svcguy/orpMeter/README.md

# orpMeter
## A basic combination pH/ORP(redox) probe electrometer circuit
This is a simple analog front end (AFE), ADC, isolated DC-DC, and SPI isolator circuit to interface to a standard combination pH or ORP probe.

## Circuit Theory of Operation
### AFE
(coming soon)
