svcguy/orpMeter/(list of files, cad)

Other CAD files:
fab/orpMeter-B_SilkS.dxf
fab/orpMeter-F_SilkS.dxf
