svcguy/orpMeter/orpMeter.kicad_pcb

## KiCad design orpMeter.kicad_pcb (2021-10-19)

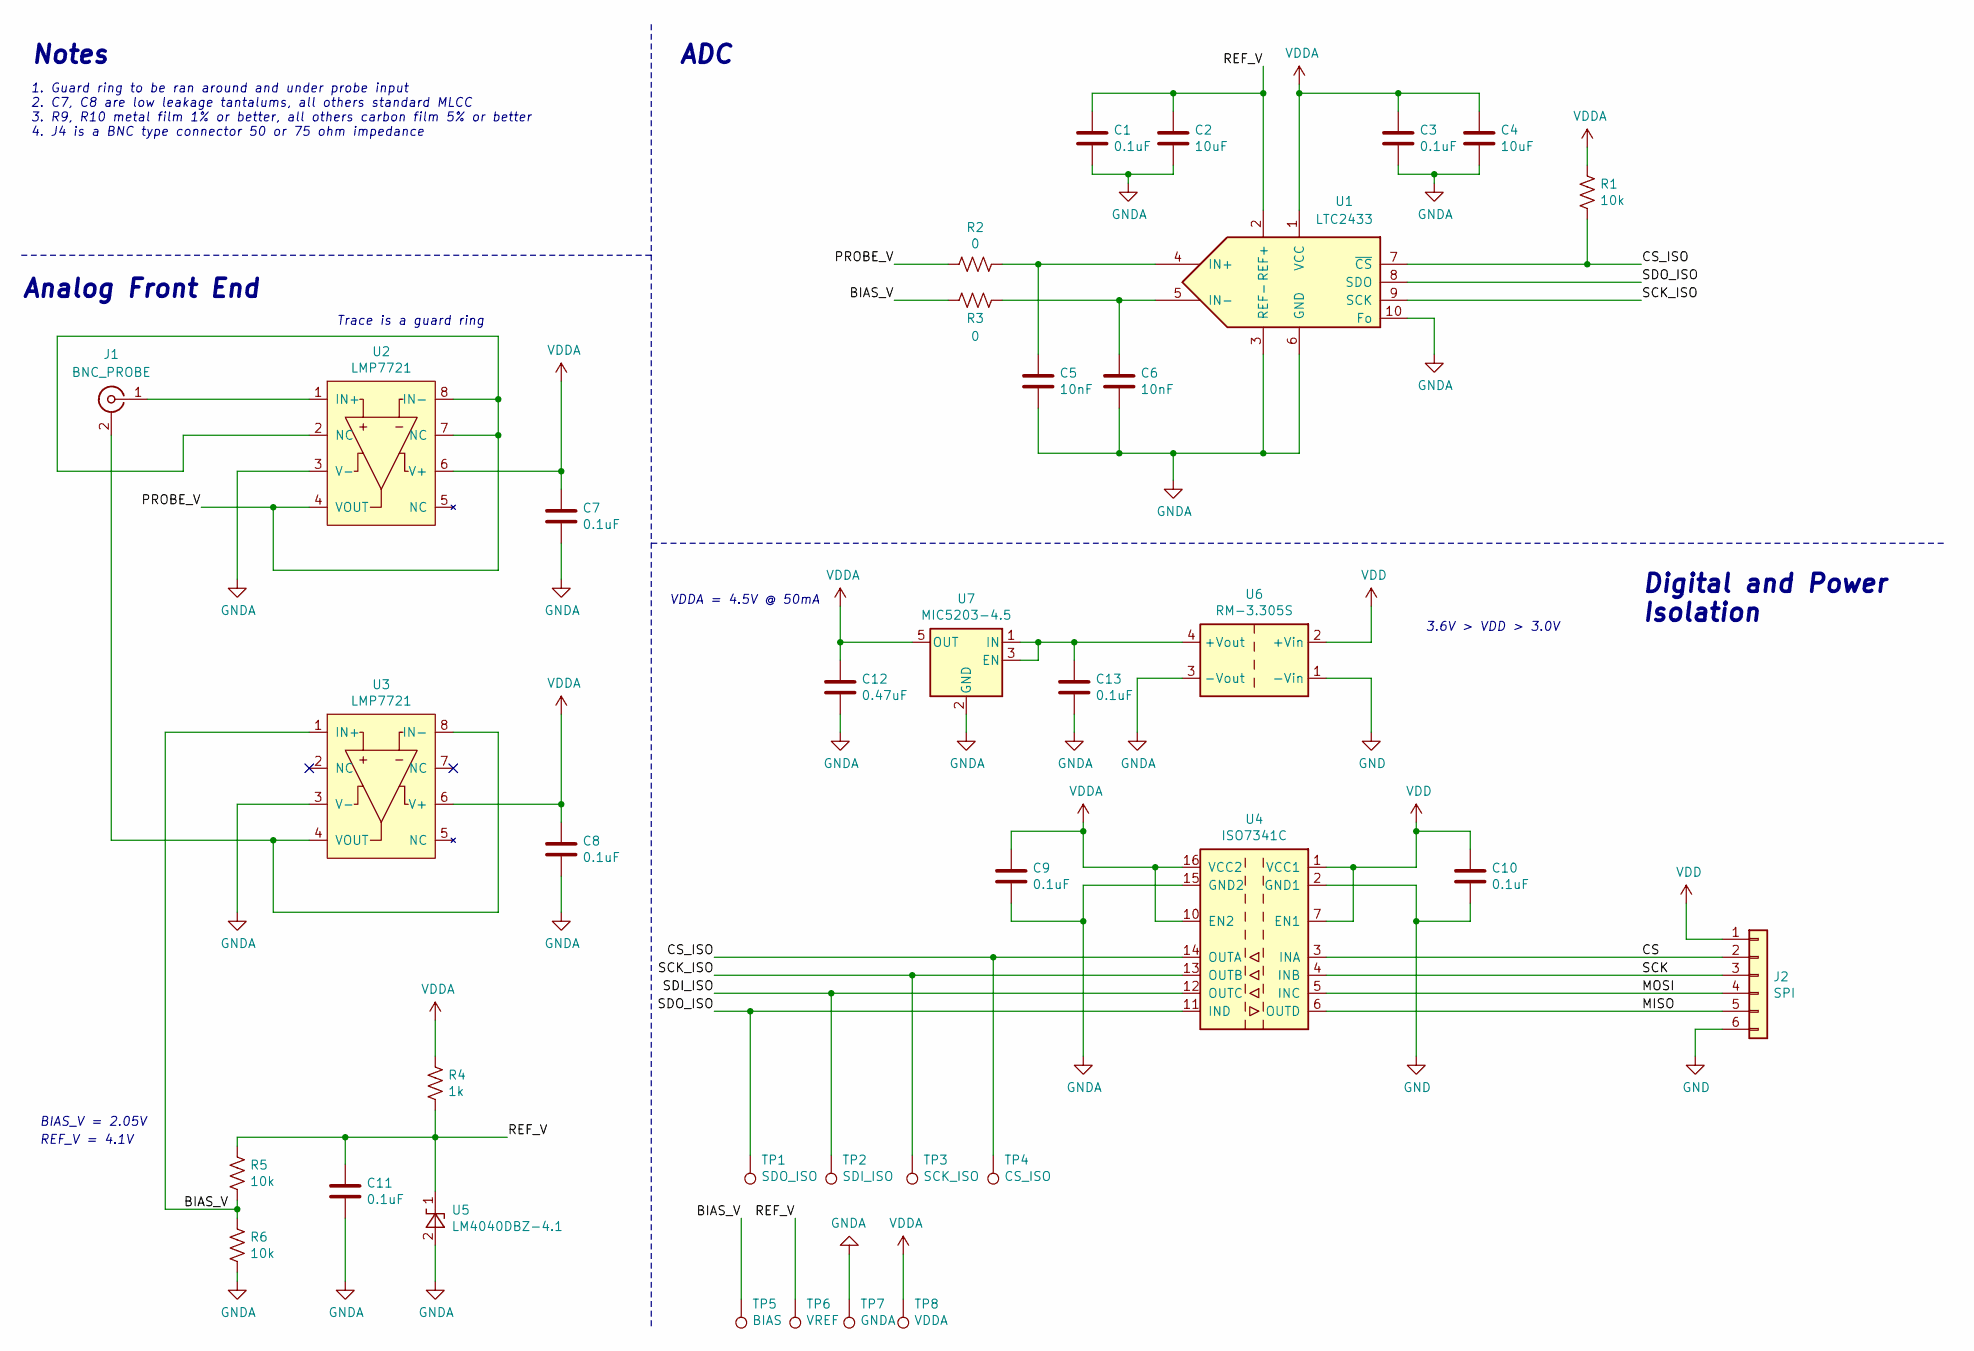
[picture p1: schematic orpMeter.sch, pH and ORP electrometer]

Parts:
C1, C3, C9, C10, C13: 0.1uF; C_0603_1608Metric; Digikey 478-3540-1-ND
C2, C4: 10uF; CP_EIA-2012-15_AVX-P
C5, C6: 10nF; C_0603_1608Metric; Digikey 399-17880-1-ND
C7, C8, C11: 0.1uF; CP_EIA-2012-15_AVX-P; Digikey 478-11592-1-ND
C12: 0.47uF; C_0603_1608Metric; Digikey 399-4922-1-ND
J1: BNC_PROBE; BNC_Amphenol_B6252HB-NPP3G-50_Horizontal; Digikey A24485-ND
J2: SPI; PinHeader_1x06_P2.54mm_Vertical; Digikey DNP
R1, R5, R6: 10k; R_0603_1608Metric; Digikey 2019-RN73H1JTTD1002B50CT-ND
R2, R3: 0; R_0603_1608Metric; Digikey 541-4013-1-ND
R4: 1k; C_0603_1608Metric; Digikey RMCF0603FG1K00CT-ND
TP1: SDO_ISO; TestPoint_Pad_2.0x2.0mm; Digikey DNP
TP2: SDI_ISO; TestPoint_Pad_2.0x2.0mm; Digikey DNP
TP3: SCK_ISO; TestPoint_Pad_2.0x2.0mm; Digikey DNP
TP4: CS_ISO; TestPoint_Pad_2.0x2.0mm; Digikey DNP
TP5: BIAS; TestPoint_Pad_2.0x2.0mm; Digikey DNP
TP6: VREF; TestPoint_Pad_2.0x2.0mm; Digikey DNP
TP7: GNDA; TestPoint_Pad_2.0x2.0mm; Digikey DNP
TP8: VDDA; TestPoint_Pad_2.0x2.0mm; Digikey DNP
U1: LTC2433; MSOP-10_3x3mm_P0.5mm; Digikey LTC2433-1CMS#PBF-ND
U2, U3: LMP7721; SOIC-8_3.9x4.9mm_P1.27mm; Digikey LMP7721IMA/NOPB-ND
U4: ISO7341C; SOIC-16W_7.5x10.3mm_P1.27mm; Digikey 296-47779-1-ND
U5: LM4040DBZ-4.1; SOT-23; Digikey LM4040DIM3-4.1/NOPBCT-ND
U6: RM-3.305S; Converter_DCDC_Murata_MEE1SxxxxSC_THT; Digikey 945-1518-5-ND
U7: MIC5203-4.5; SOT-23-5; Digikey MIC5203-4.5YM5-CT-ND

Connections:
/BIAS_V: R3.2, R5.2, R6.1, TP5.1, U3.1 (IN+)
/CS: J2.2, U4.3 (INA)
/CS_ISO: R1.2, TP4.1, U1.7 (~CS), U4.14 (OUTA)
/MISO: J2.5, U4.6 (OUTD)
/MOSI: J2.4, U4.5 (INC)
/PROBE_V: R2.2, U2.2 (NC), U2.4 (VOUT), U2.7 (NC), U2.8 (IN-)
/REF_V: C1.1, C2.1, C11.1, R4.2, R5.1, TP6.1, U1.2 (REF+), U5.1 (K)
/SCK: J2.3, U4.4 (INB)
/SCK_ISO: TP3.1, U1.9 (SCK), U4.13 (OUTB)
/SDI_ISO: TP2.1, U4.12 (OUTC)
/SDO_ISO: TP1.1, U1.8 (SDO), U4.11 (IND)
GND: C10.2, J2.6, U4.2 (GND1), U4.8 (GND1), U6.1 (-Vin)
GNDA: C1.2, C2.2, C3.2, C4.2, C5.2, C6.2, C7.2, C8.2, C9.2, C11.2, C12.2, C13.2, R6.2, TP7.1, U1.3 (REF-), U1.6 (GND), U1.10 (Fo), U2.3 (V-), U3.3 (V-), U4.9 (GND2), U4.15 (GND2), U5.2 (A), U6.3 (-Vout), U7.2 (GND)
unnamed: C5.1, R2.1, U1.4 (IN+)
unnamed: C6.1, R3.1, U1.5 (IN-)
unnamed: C13.1, U6.4 (+Vout), U7.1 (IN), U7.3 (EN)
unnamed: J1.1 (In), U2.1 (IN+)
unnamed: J1.2 (Ext), U3.4 (VOUT), U3.8 (IN-)
VDD: C10.1, J2.1, U4.1 (VCC1), U4.7 (EN1), U6.2 (+Vin)
VDDA: C3.1, C4.1, C7.1, C8.1, C9.1, C12.1, R1.1, R4.1, TP8.1, U1.1 (VCC), U2.6 (V+), U3.6 (V+), U4.10 (EN2), U4.16 (VCC2), U7.5 (OUT)

Notes on the sheet:
BIAS_V = 2.05V
Trace is a guard ring
REF_V = 4.1V
3.6V > VDD > 3.0V
VDDA = 4.5V @ 50mA
Analog Front End
ADC
Digital and Power Isolation
Notes
1. Guard ring to be ran around and under probe input 2. C7, C8 are low leakage tantalums, all others standard MLCC 3. R9, R10 metal film 1% or better, all others carbon film 5% or better 4. J4 is a BNC type connector 50 or 75 ohm impedance

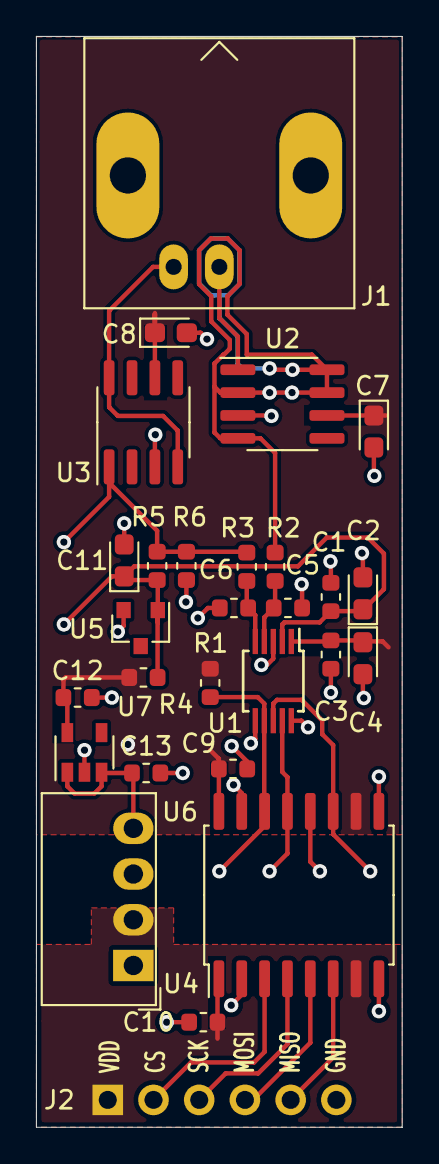
[picture p2: board orpMeter.kicad_pcb from above]

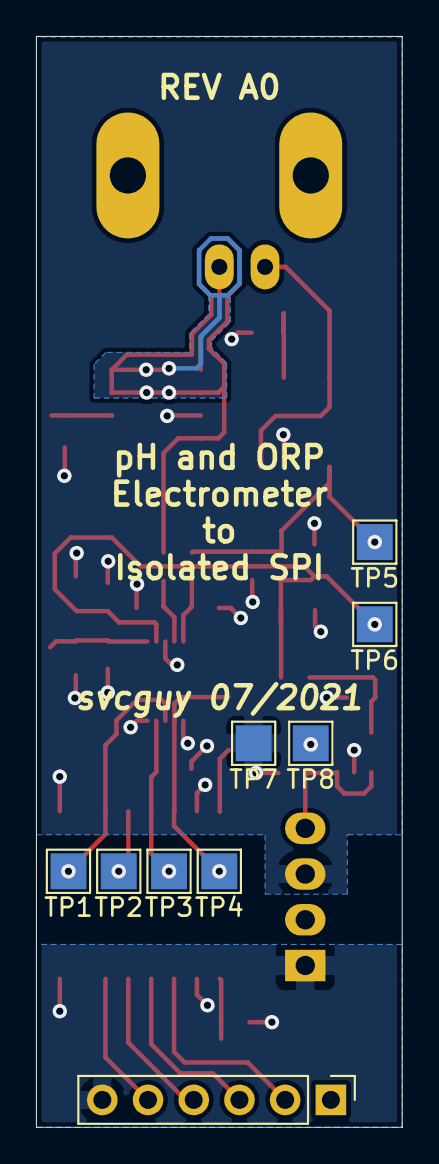
[picture p3: board orpMeter.kicad_pcb from below]

Board: 2 copper layers, 20.3 x 60.6 mm, 36 parts (9 on the bottom side), 20 nets.
